SeniorDesignTeamOmicron/Insole-Hardware/Design Documentation/Possible Capacitor Dimensions.pdf

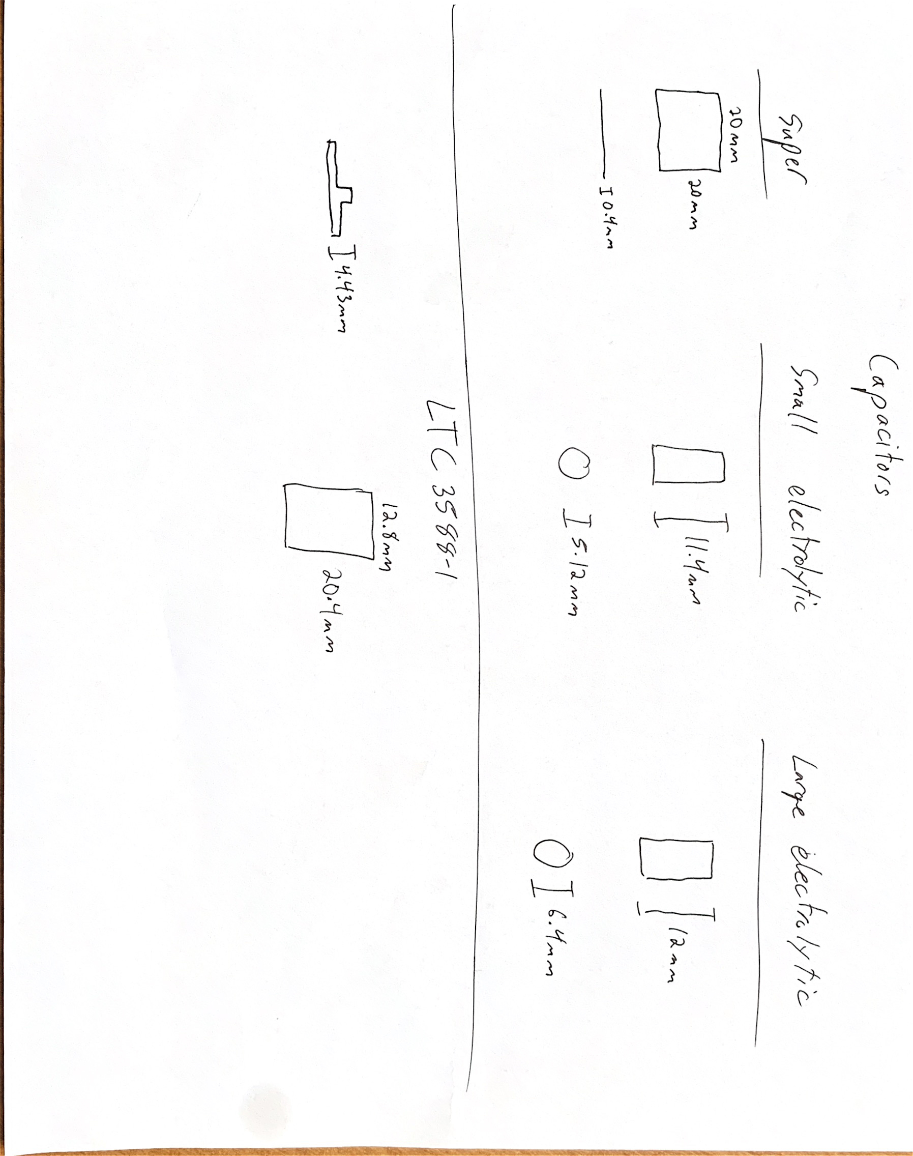
[picture p21: page 1]
