SeniorDesignTeamOmicron/Insole-Hardware/Design Documentation/Images/piezo2.jpg

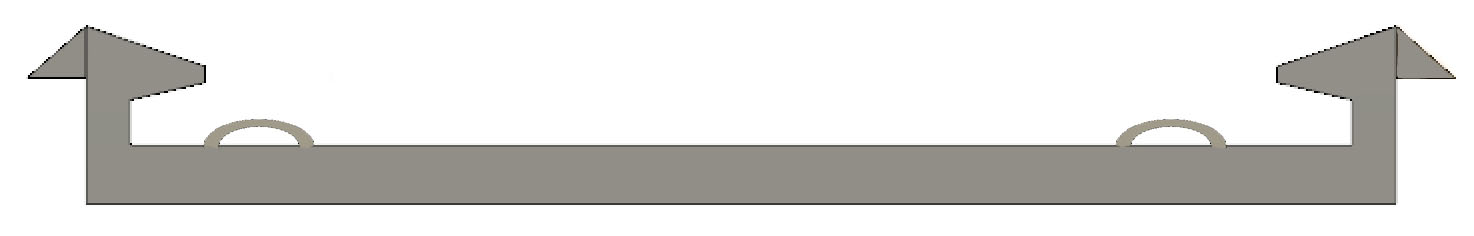
Design Documentation/Images/piezo2.jpg
