SeniorDesignTeamOmicron/Insole-Hardware/Design Documentation/Images/piezo.jpg

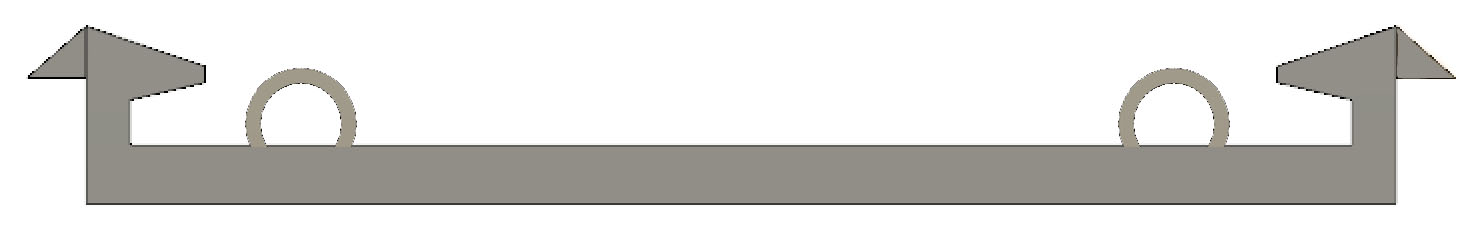
Design Documentation/Images/piezo.jpg
