SeniorDesignTeamOmicron/Insole-Hardware/Design Documentation/Images/Screen Shot 2019-01-15 at 9.48.17 PM.png

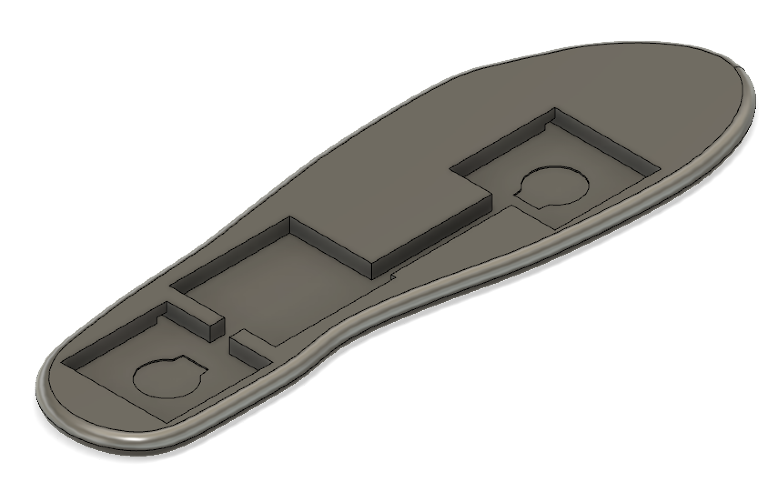
Design Documentation/Images/Screen Shot 2019-01-15 at 9.48.17 PM.png
