SeniorDesignTeamOmicron/Insole-Hardware/Design Documentation/Images/Screen Shot 2019-01-17 at 4.41.34 PM.png

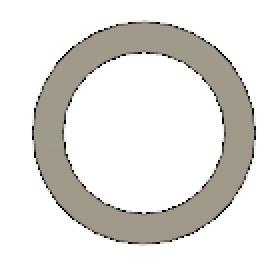
Design Documentation/Images/Screen Shot 2019-01-17 at 4.41.34 PM.png
