SeniorDesignTeamOmicron/Insole-Hardware/Design Documentation/Images/Screen Shot 2019-01-17 at 6.19.45 PM.png

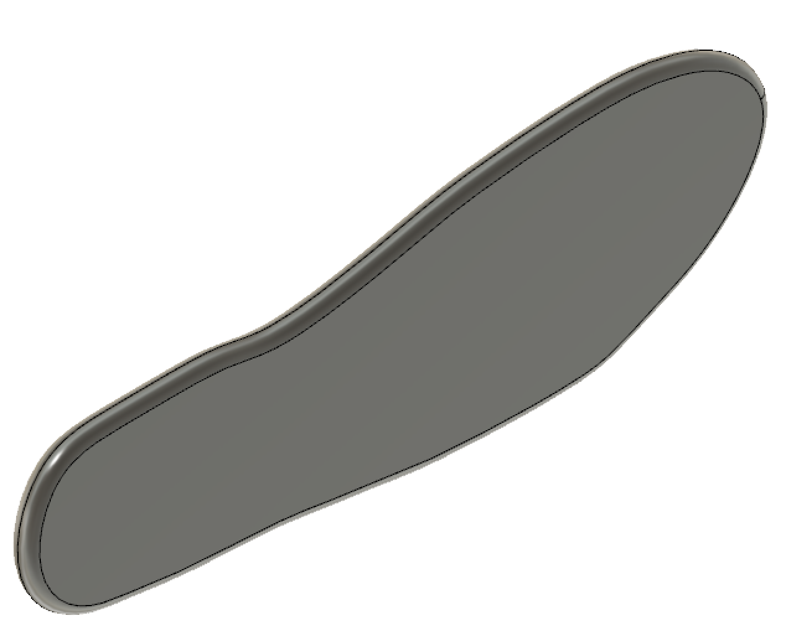
Design Documentation/Images/Screen Shot 2019-01-17 at 6.19.45 PM.png
