SeniorDesignTeamOmicron/Insole-Hardware/Research/Piezo Waveform.PNG

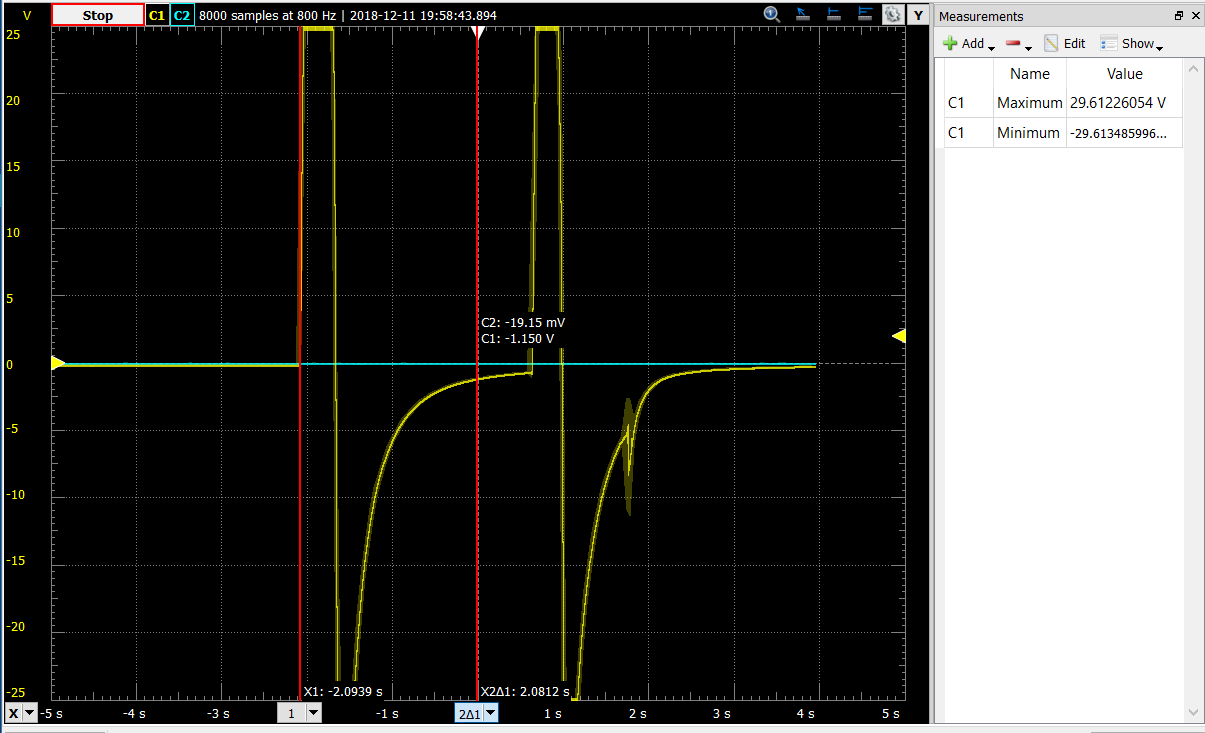
Research/Piezo Waveform.PNG
