SeniorDesignTeamOmicron/Insole-Hardware/Design Documentation/Possible Peizo Component Dimensions.pdf

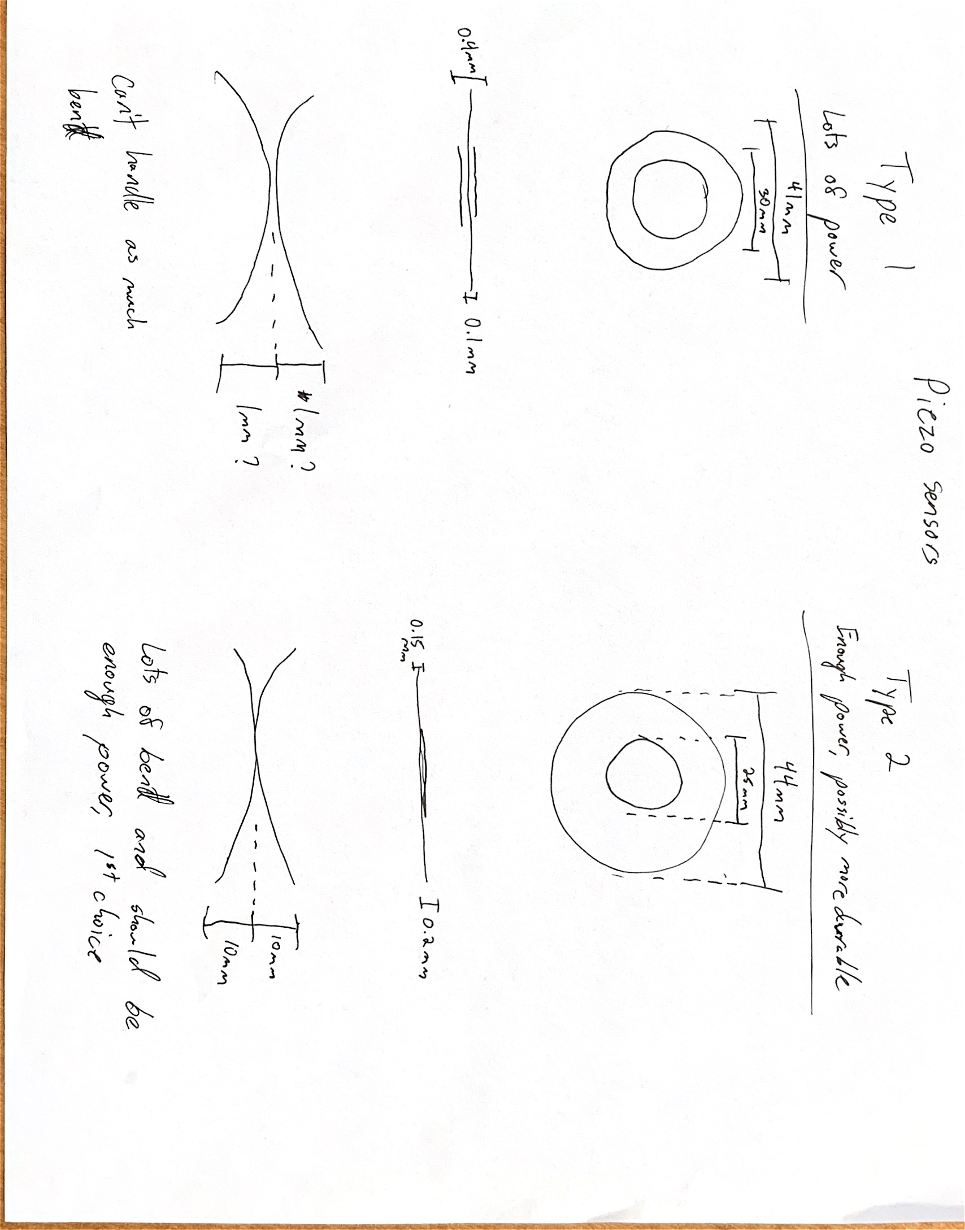
[picture p32: page 1]
