SeniorDesignTeamOmicron/Insole-Hardware/Design Files/Base Insole Sketch.dxf

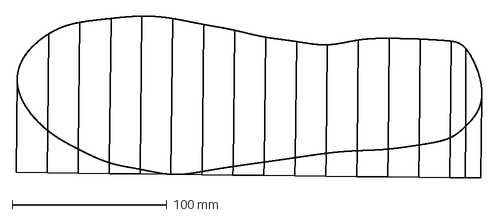
[picture p33: CAD file, 2018-12-12]
Design Files/Base Insole Sketch.dxf
300.7 x 104.4 mm
