SeniorDesignTeamOmicron/Insole-Hardware/Design Files/Protoype V1 Design Files/Activator Cap.step

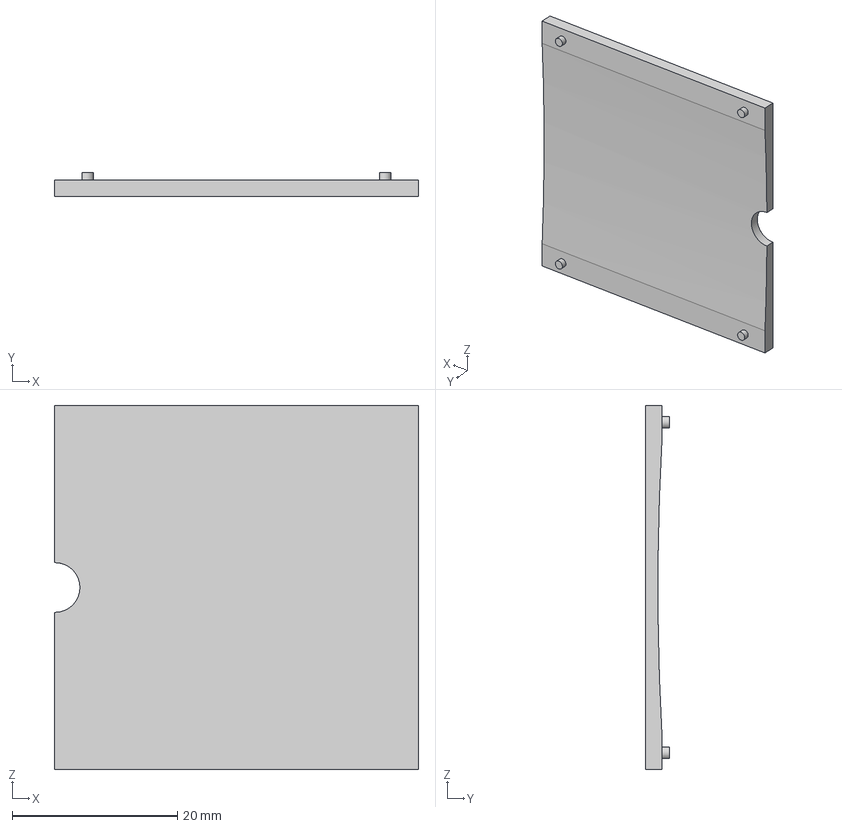
[picture p34: CAD file, 2018-11-29]
Design Files/Protoype V1 Design Files/Activator Cap.step
44.0 x 2.90 x 44.0 mm
