SeniorDesignTeamOmicron/Insole-Hardware/Design Files/Protoype V1 Design Files/Insole.step

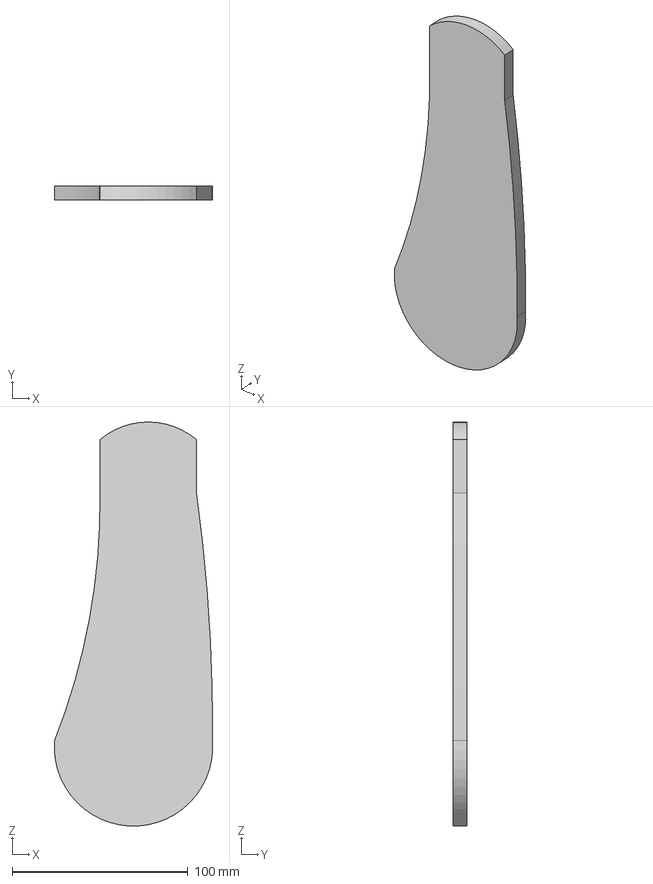
[picture p35: CAD file, 2018-11-29]
Design Files/Protoype V1 Design Files/Insole.step
90.2 x 8.00 x 230.2 mm
