SeniorDesignTeamOmicron/Insole-Hardware/Design Files/Protoype V1 Design Files/Activator Decompressor.step

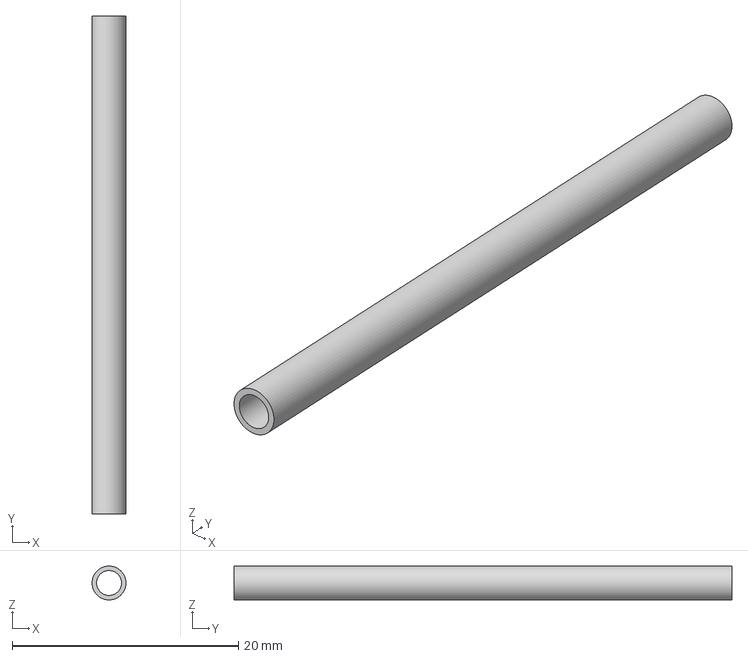
[picture p36: CAD file, 2018-11-29]
Design Files/Protoype V1 Design Files/Activator Decompressor.step
3.00 x 44.0 x 3.00 mm
