SeniorDesignTeamOmicron/Insole-Hardware/Design Files/Protoype V1 Design Files/Activator Base.step

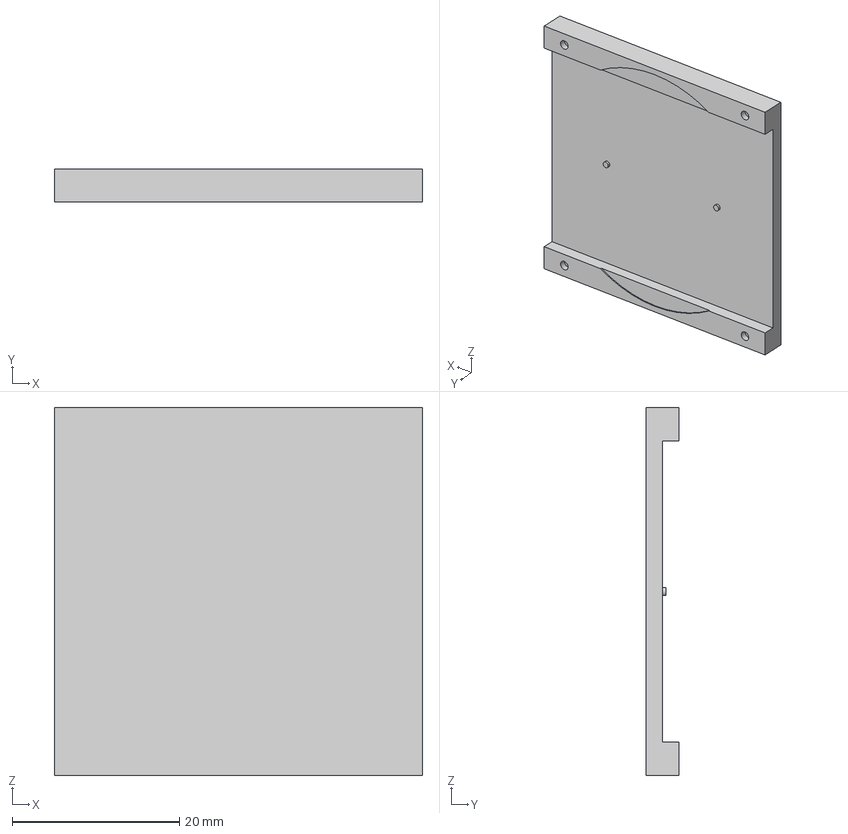
[picture p37: CAD file, 2018-11-29]
Design Files/Protoype V1 Design Files/Activator Base.step
44.0 x 4.00 x 44.0 mm
