SeniorDesignTeamOmicron/Insole-Hardware/(commit log)

2018-11-29 Added design files for first insole prototype.
    [Activator Base.step, Activator Cap.step, Activator Decompressor.step, Insole.step]
2018-12-12 Add files via upload
    Waveform of piezo buzzer in 4mm insole component when pressed
2018-12-12 Added some documentation
    [Base Insole Sketch.dxf]
2019-01-21 Reorganizing files
    [Activator Base.step, Activator Cap.step, Activator Decompressor.step, Base Insole Sketch.dxf, Insole.step]
